odevincenti/E4-TPF-G2/Mediciones/scope2_tpf1.png

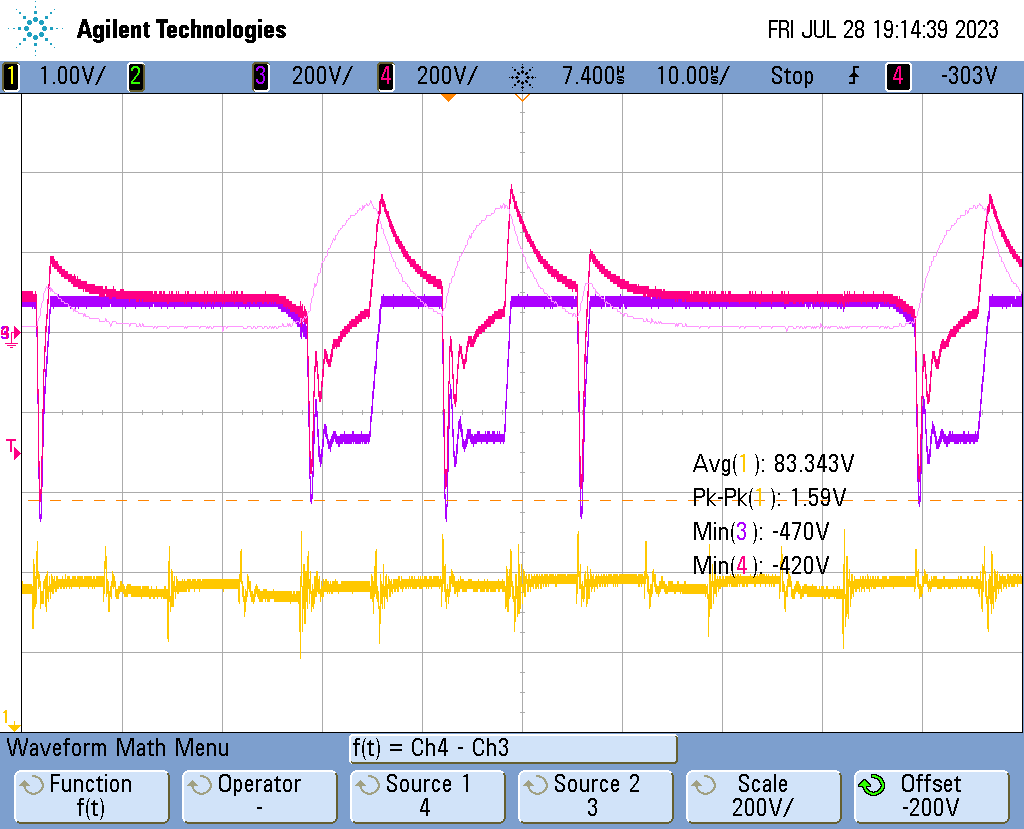
Mediciones/scope2_tpf1.png
