odevincenti/E4-TPF-G2/Mediciones/scope_tpf0.png

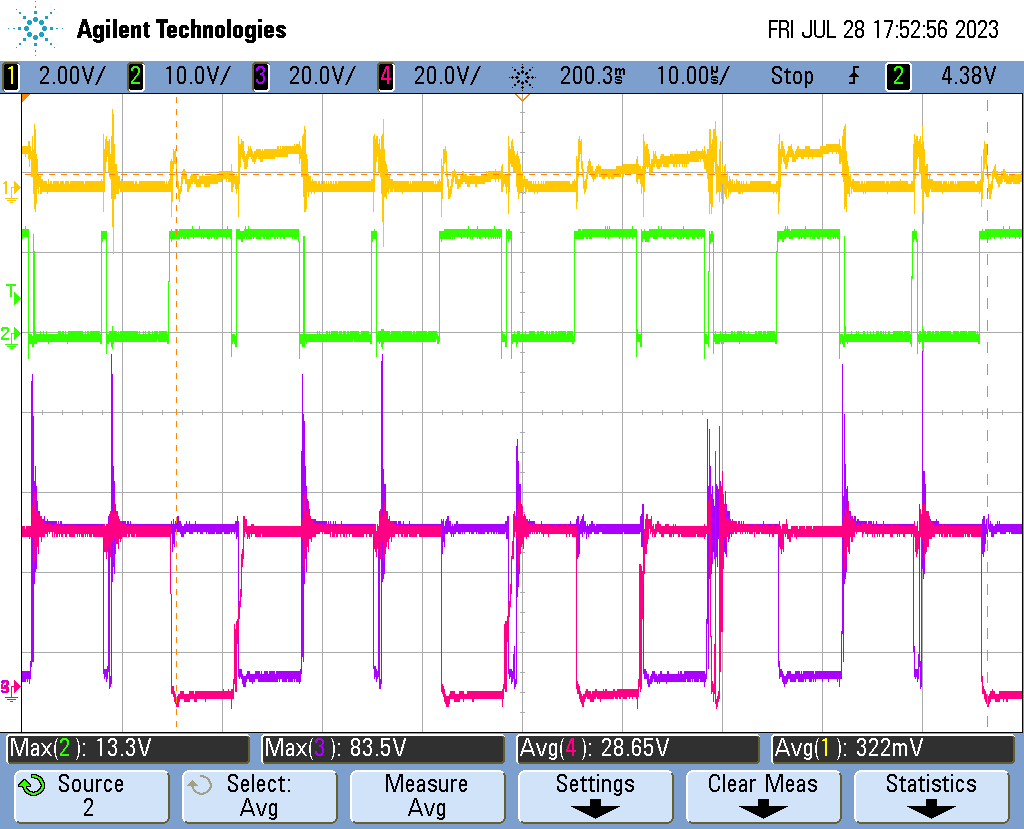
Mediciones/scope_tpf0.png
