odevincenti/E4-TPF-G2/Mediciones/scope_tpf1.png

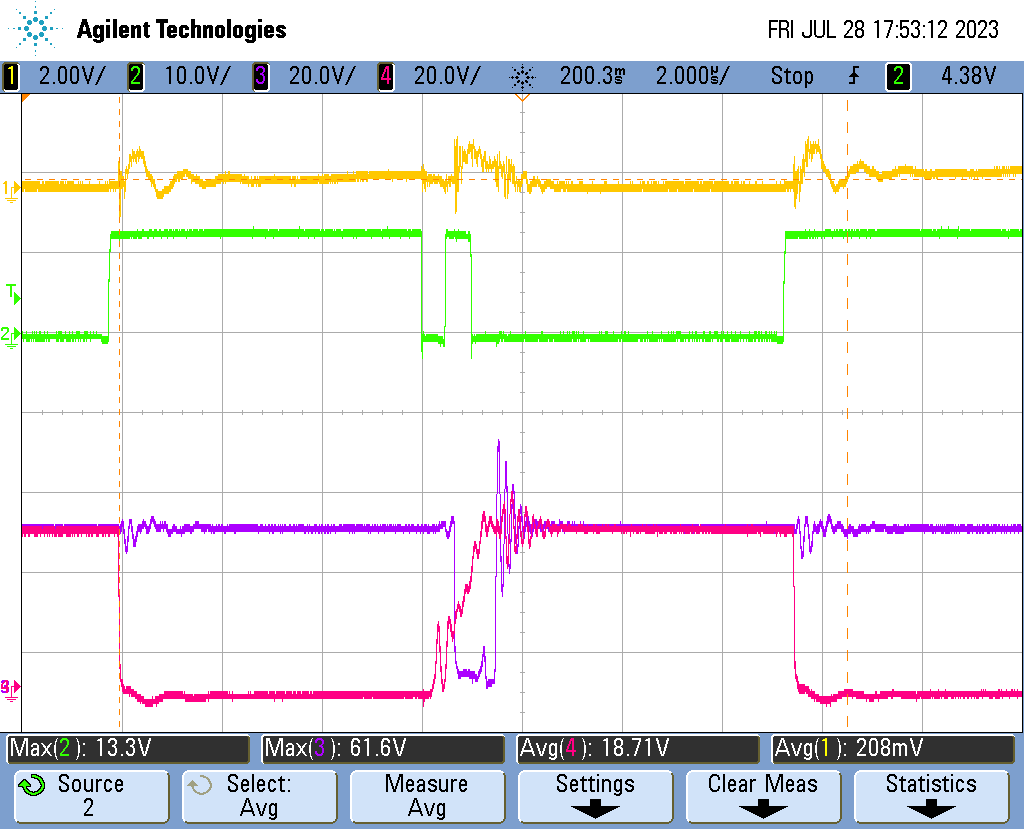
Mediciones/scope_tpf1.png
