odevincenti/E4-TPF-G2/Mediciones/scope_tpf2.png

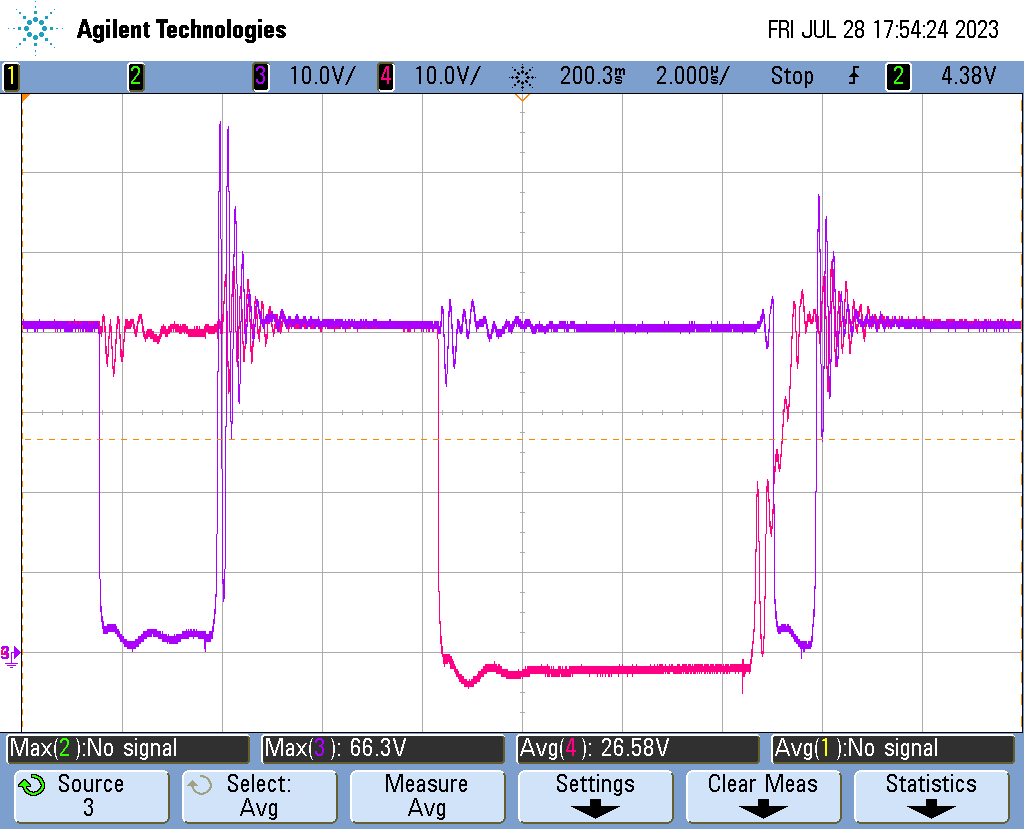
Mediciones/scope_tpf2.png
