odevincenti/E4-TPF-G2/Mediciones/scope_tpf3.png

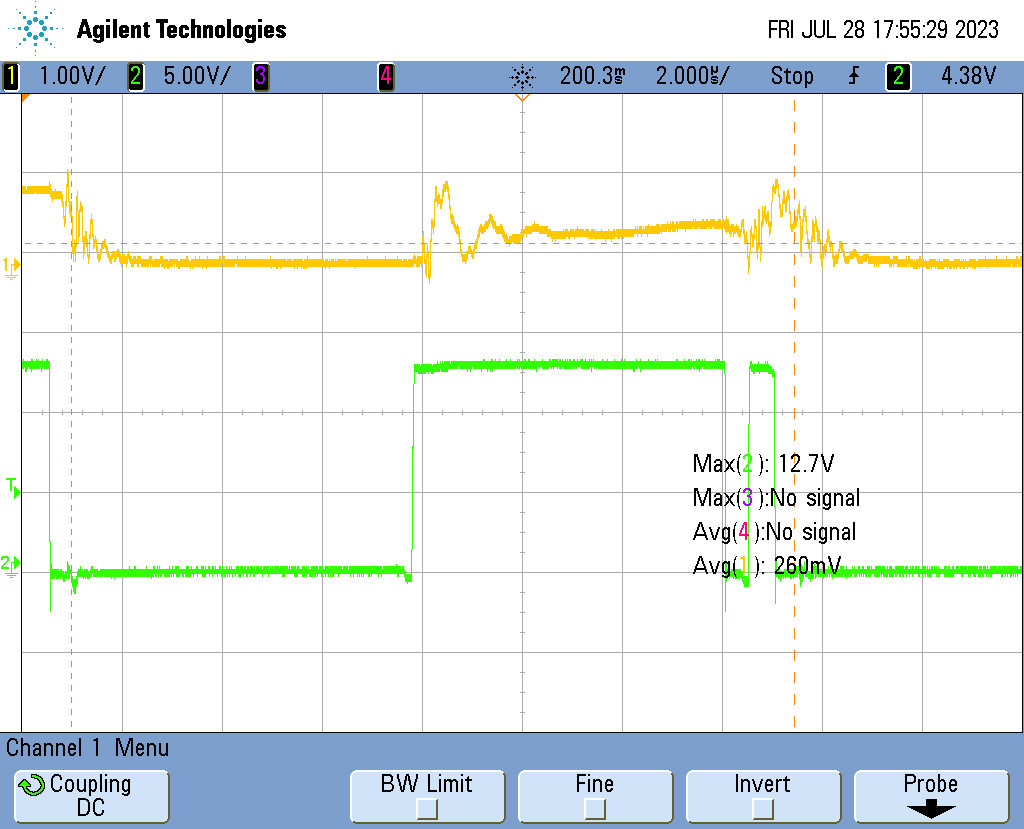
Mediciones/scope_tpf3.png
