odevincenti/E4-TPF-G2/Mediciones/scope_tpf4.png

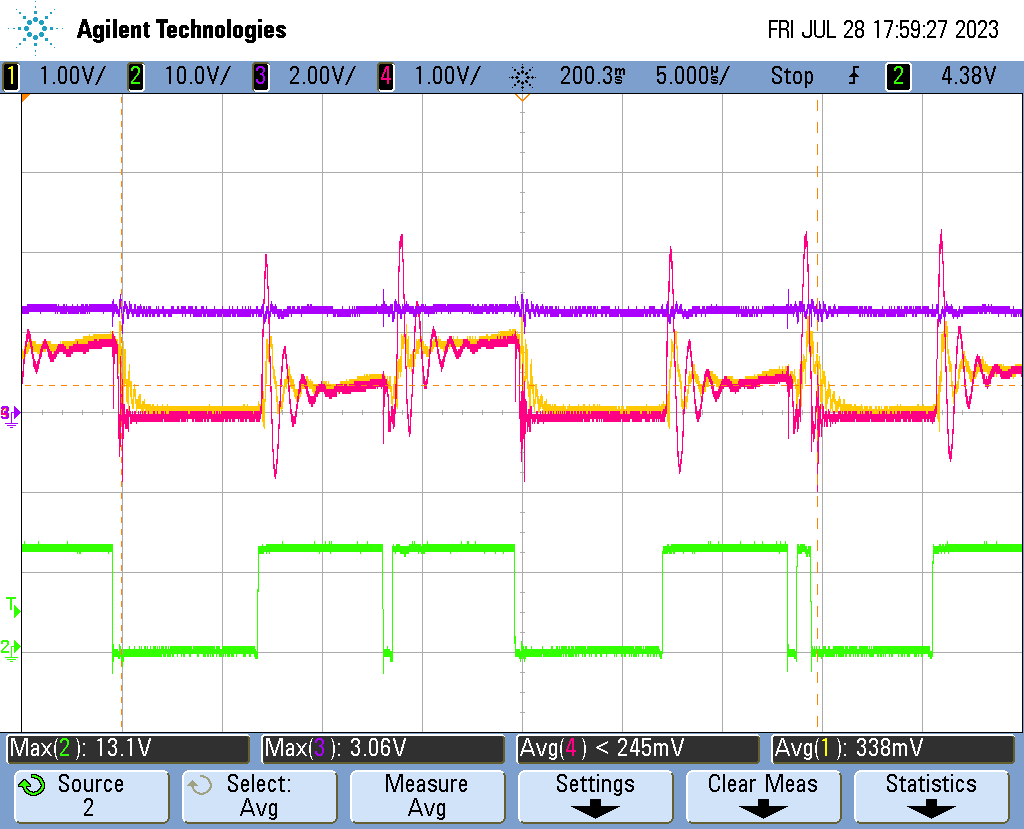
Mediciones/scope_tpf4.png
