odevincenti/E4-TPF-G2/Mediciones/scope_tpf5.png

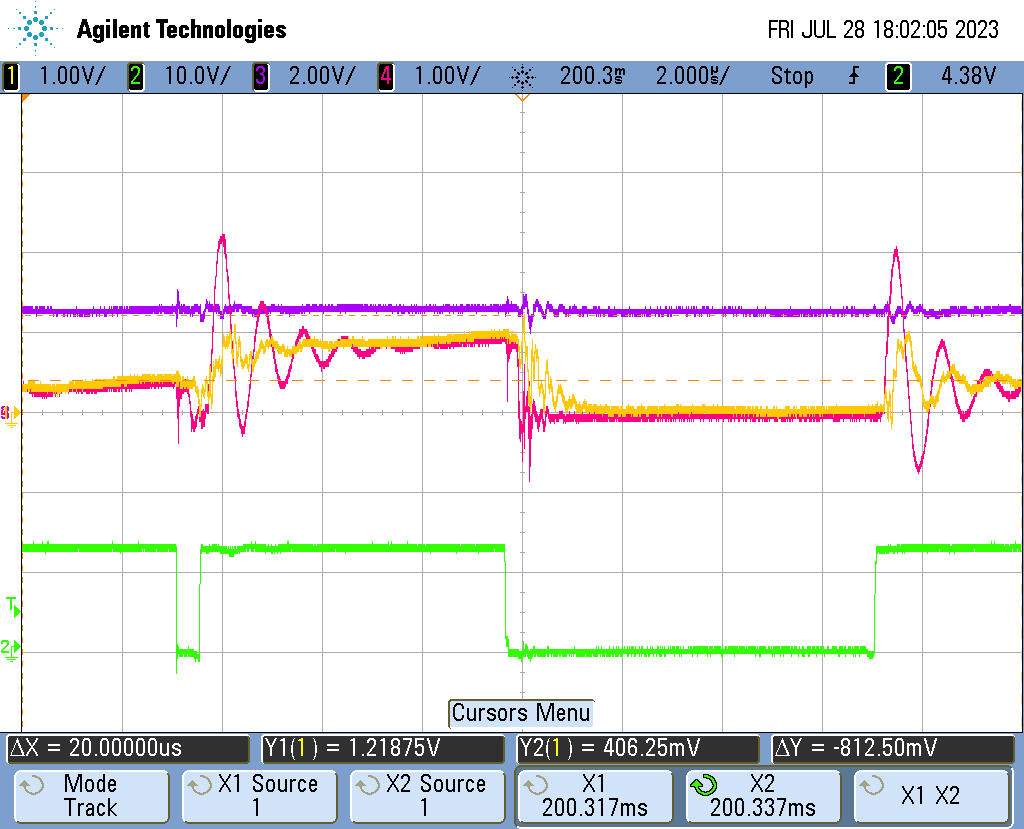
Mediciones/scope_tpf5.png
