odevincenti/E4-TPF-G2/Mediciones/scope_tpf6.png

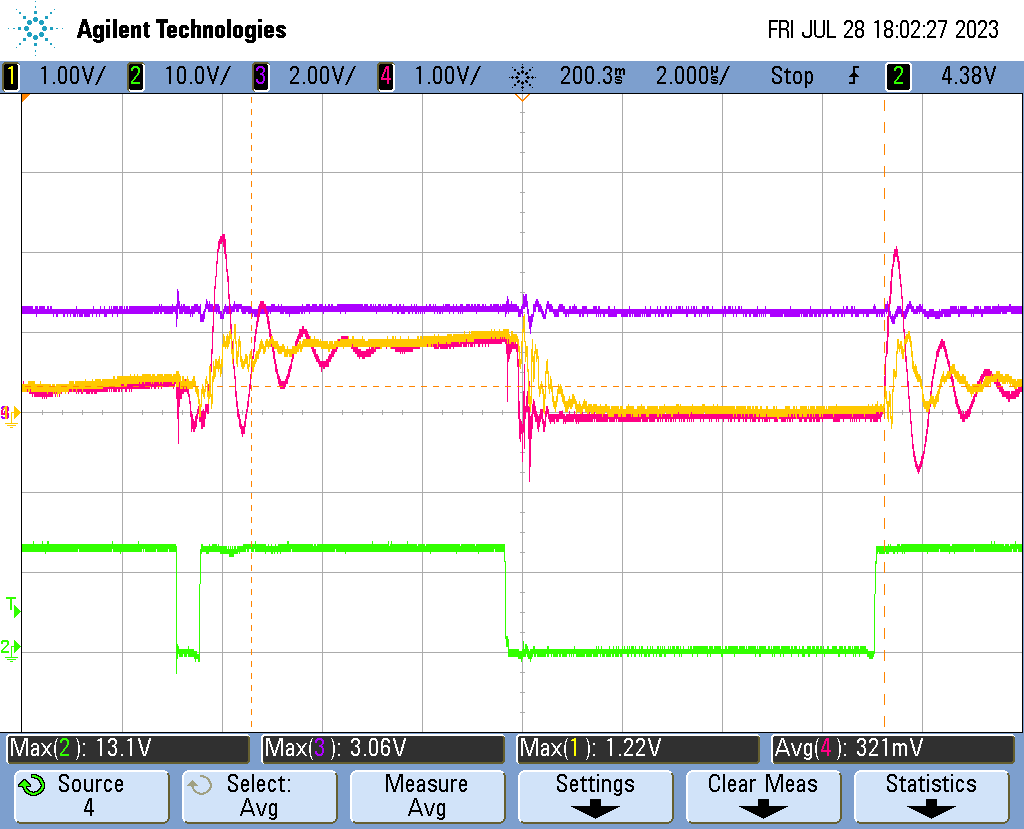
Mediciones/scope_tpf6.png
