odevincenti/E4-TPF-G2/Scripts/Flyback_Interleave.png

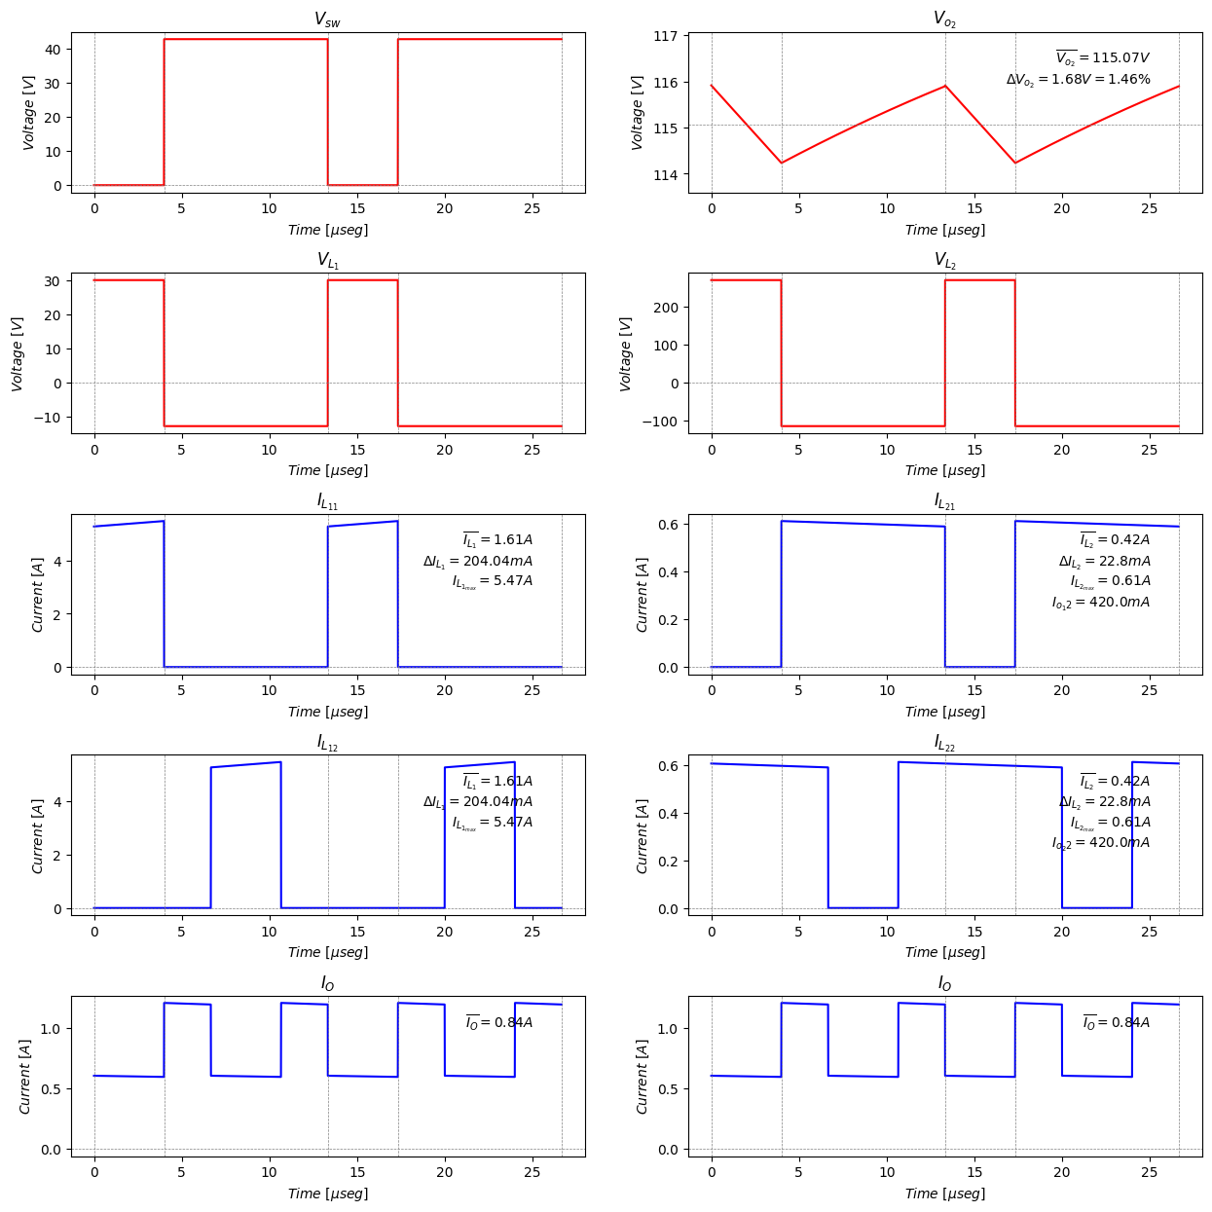
Scripts/Flyback_Interleave.png
