odevincenti/E4-TPF-G2/PCB/TPF-EIV-G2/Schematic.pdf

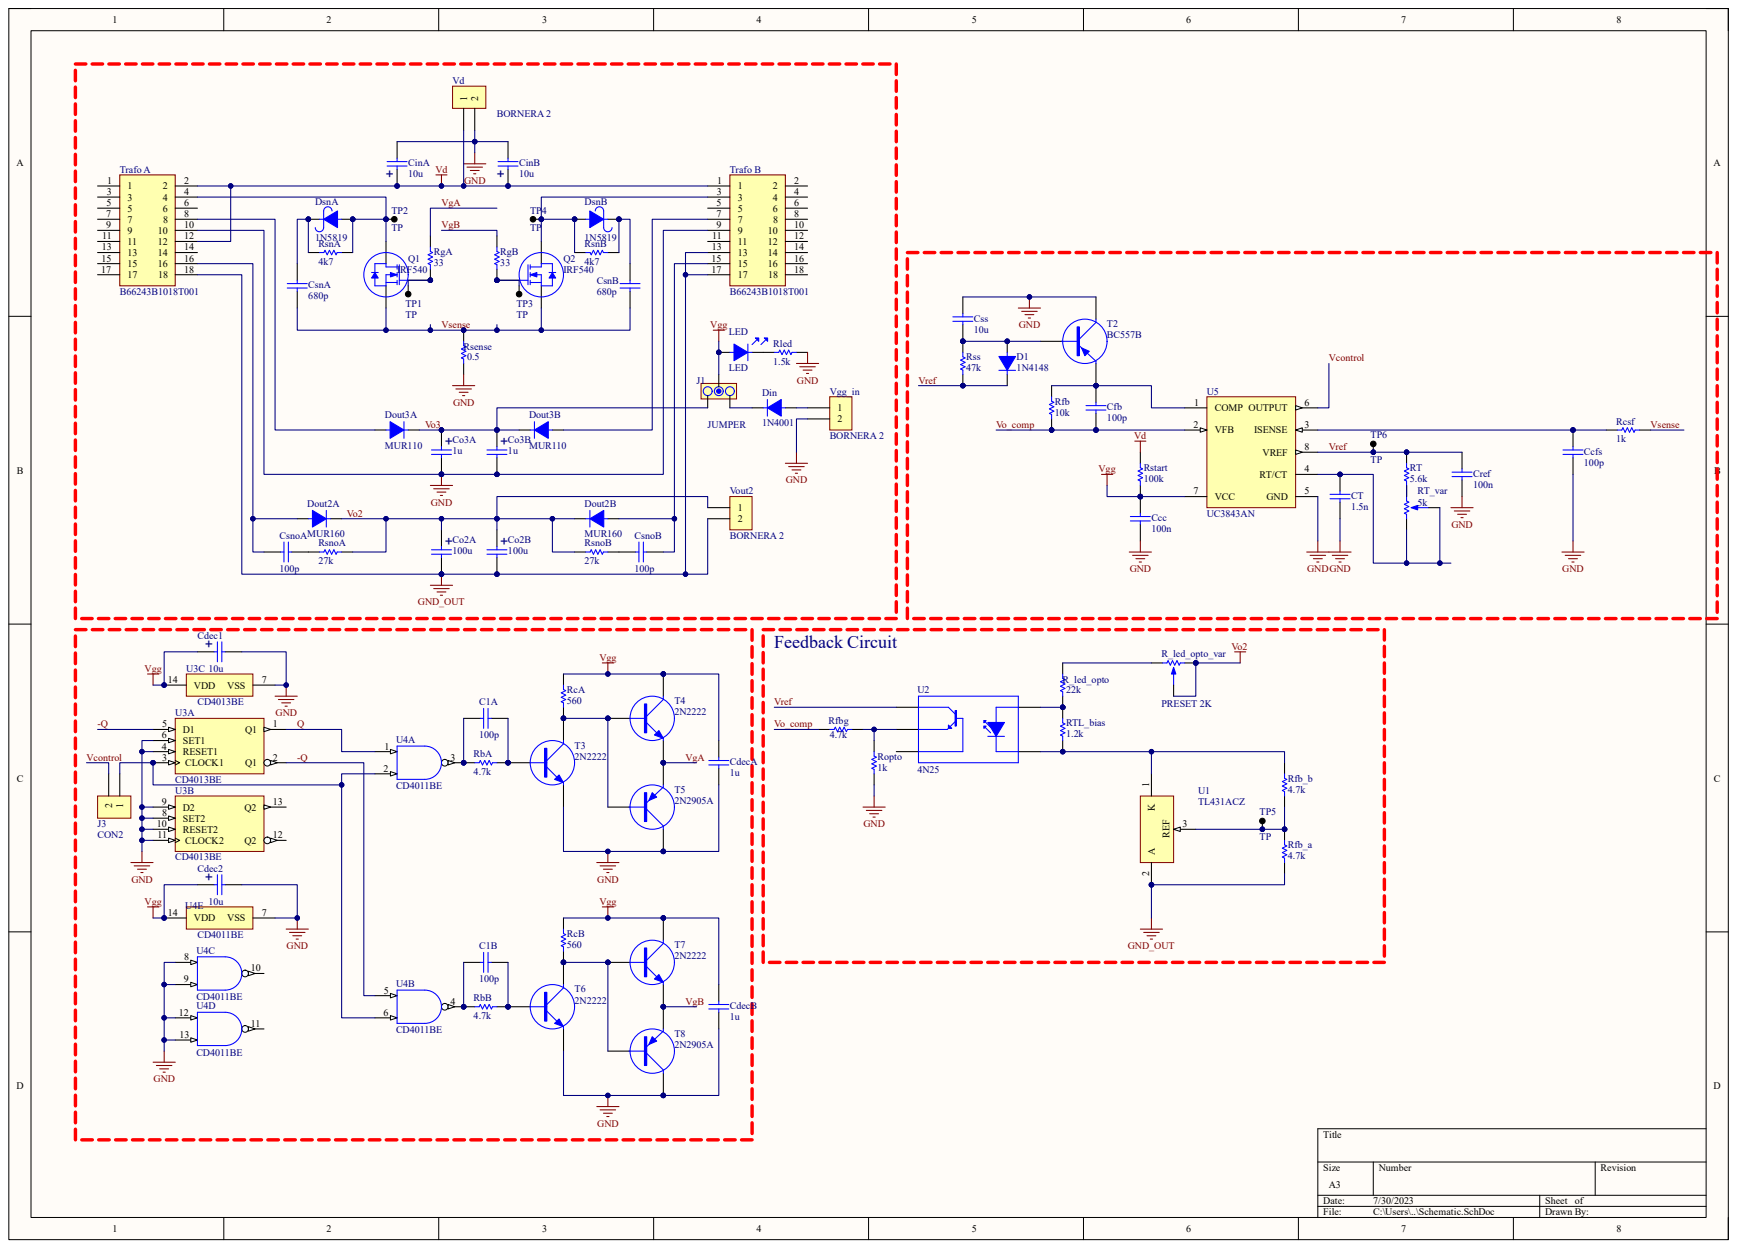
[picture p19: page 1]
