odevincenti/E4-TPF-G2/PCB/TPF-EIV-G2/E4_TPF.pdf

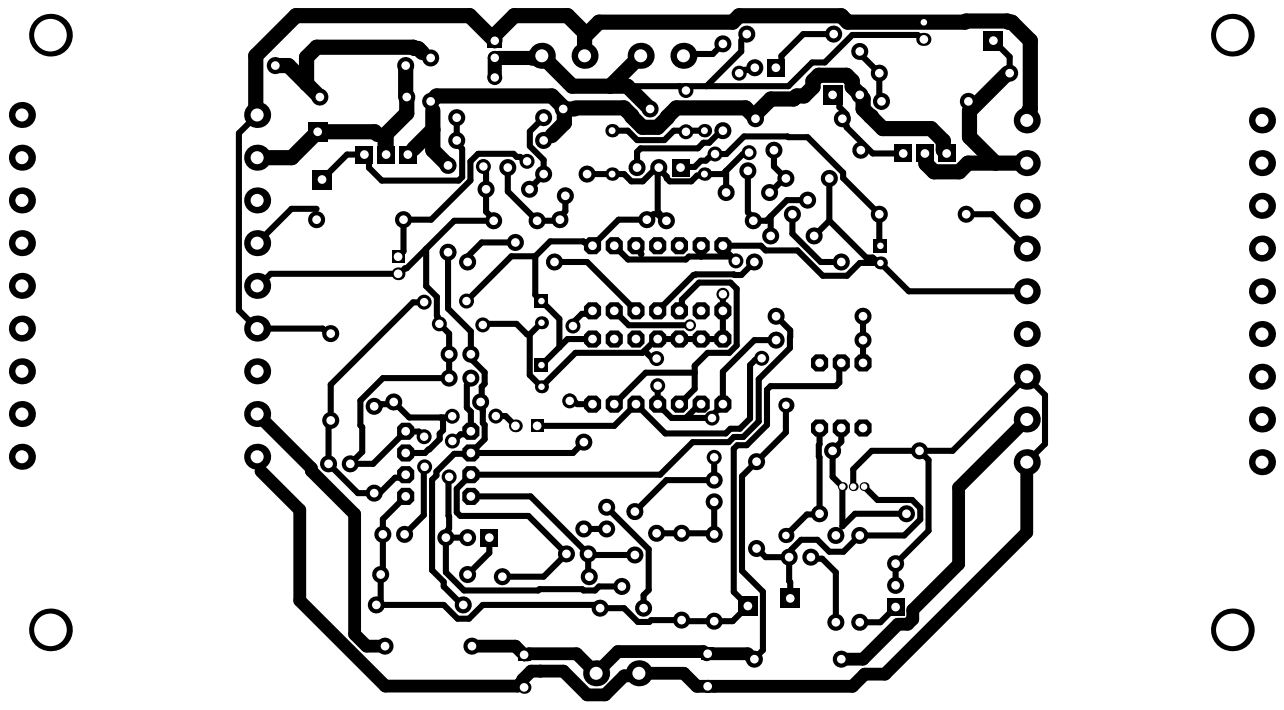
[picture p20: page 1]
