odevincenti/E4-TPF-G2/PCB/TPF-EIV-G2/E4_TPF_Top.pdf

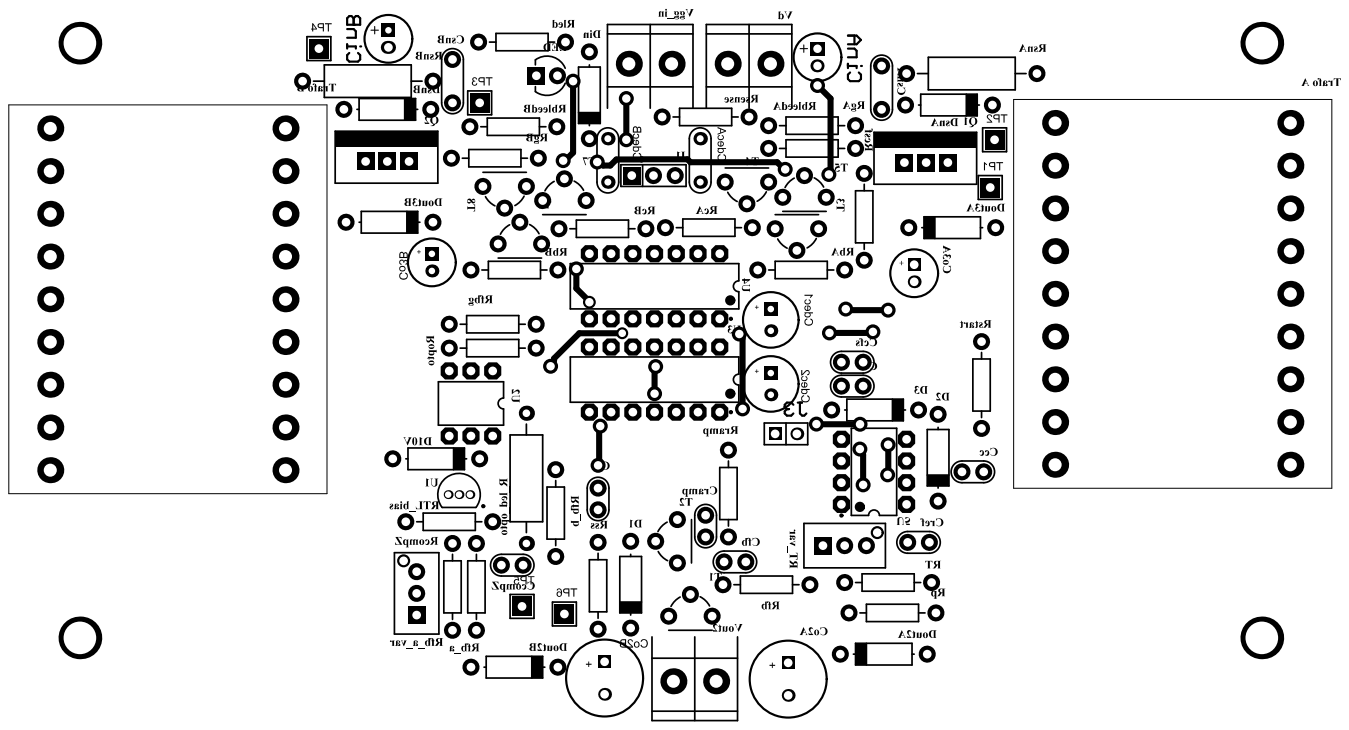
[picture p21: page 1]
