odevincenti/E4-TPF-G2/Simulaciones/Interleaved_Flyback_Experimental.asc

C2: cap; 1µ
C3: cap; 1µ
Ccc: cap; 100n
Ccfs: cap; 1n
Cfb: cap; 180n
Cramp: cap; 10n
Cref: cap; 100n
CsnA: cap; 680p
CsnB: cap; 680p
Css: cap; 10µ
CT: cap; 1.5n
D1: schottky; 1N5817
D2: schottky; 1N5817
D2A: diode; MUR160
D2B: diode; MUR160
D3A: diode; MUR110
D3B: diode; MUR110
D10V: zener; BZX84C10L
DsnA: schottky; 1N5819
DsnB: schottky; 1N5819
Dss: diode; 1N4148
ESR2: res; 0.2
ESR3: res; 0.2
L1A: ind2; 476µ
L1B: ind2; 476µ
L2A: ind2; 38.1m
L2B: ind2; 38.1m
L3A: ind2; 933µ
L3B: ind2; 933µ
LdA: ind; 29.4µ
LdB: ind; 29.4µ
LED: LED
Q1: npn; BC547B
Q1A: npn; 2N2222
Q1B: npn; 2N2222
Q2A: pnp; 2N2905A
Q2B: pnp; 2N2905A
Q3: pnp; BC557B
QcA: npn; 2N2222
QcB: npn; 2N2222
RbA: res; 4.7k
RbB: res; 4.7k
RbleederA: res; 10k
RbleederB: res; 10k
RcA: res; 560
RcB: res; 560
Rcsf: res; 470
Rfb: res; 10k
Rfb_a: res; 4.7k
Rfb_b: res; 4.7k
Rfbg: res; 10k
RgA: res; 33
RgB: res; 33
rL1A: res; 0.1
rL1B: res; 0.1
RL2: res; 1.1k
rL2A: res; 2
rL2B: res; 2
RL3: res; 220
rL3A: res; 0.1
rL3B: res; 0.1
Rled: res; 1k
Rled_bias: res; 1.2k
Rled_opto2: res; 1
Rled_opto: res; 24.2k
Ropto: res; 1k
Rp: res; 82k
Rramp: res; {Rramp}
Rsense: res; 0.47
RsnA: res; 220
RsnB: res; 220
Rss: res; 47k
Rstart: res; 100k
RT: res; 5.6k
RT_var: res; 1.15k
U1: TL431
U2: CD4013B; VDD={VDD}  SPEED=1.0  TRIPDT=5e-9
U3: CD4011B; VDD={VDD}  SPEED=1.0  TRIPDT=5e-9
U4: CD4011B; VDD={VDD}  SPEED=1.0  TRIPDT=5e-9
UA: irf540
UB: irf540
V1: voltage; 25
V2: voltage; PULSE(0 18 0 0 0 10 10)
V3: voltage; {VDD}
V4: voltage; PULSE(110 115 0 3.33u 3.33u 0 6.66u)
V5: voltage; SINE(0 0.6 2Meg 0 1Meg) trigger V(osc)>1.044
VA1: voltage; PULSE(0 18 0 0 0 3.3u 6.665u)
X1: UC3843A
X2: 4n35h
Named nets: 0, Vd, VgA, VgB, Vgg, Vcontrol, Vo3, Vsense, Vo2, Err, Vfb, Vref, Vcc, Out, Ifb, Osc, Vo_comp, Q, _Q, VDD, Vfeed, TLREF, TLK
Directivas Spice
.tran 0 10m 10n uic
KA L1A L2A L3A 1
KB L1B L2B L3B 1
Preset 5k
Preset
100 Ohm
Fuente para simular
En el esquematico real Vo3 es Vgg
Interleaved Flyback
Circuito de disparo
Circuito de control
Realimentación
Electrónica IV - TP Final 2023 - Grupo 2
.param VDD=18V
.lib CD4000.lib
.step param Rramp list 10k 100k 1Mega
.param Rramp 780k
.model MUR160 D(Is=1.043p Rs=5 Ikf=2.705m N=1 Xti=2 Eg=1.11 Cjo=28.43p M=.6225 Vj=.75 Fc=.5 Isr=7.011n Nr=2 Tt=123.3n Iave=1.0A Vpk=600.0V mfg=Motorola type=silicon Vp=25m)
