odevincenti/E4-TPF-G2/Simulaciones/Testing_TL431.asc

CcompZ: cap; 0.01µ
R1: res; {R}
R2: res; 200
RcompZ: res; 88.7k
Rfb_a: res; 2.49k
Rfb_b: res; 9.53k
Rfbg: res; 4.99k
Rled_opto: res; 5k
Ropto: res; 1k
U1: tl431
V4: voltage; {12+I*R}
V6: voltage; 5
X2: 4n35h
Named nets: Vo2, 0, Vo_comp, Vref
Directivas Spice
.tran 0 100m 0 1u uic
Realimentación
.param R = 10
.param I = 50mA
