odevincenti/E4-TPF-G2/Simulaciones/Testing_TL431_b.asc

R1: res
R2: res; 1.3k
Rfb_a: res; 5k
Rfb_b: res; 5k
U1: tl431
V4: voltage; 112.5
Named nets: Vo2, 0
Directivas Spice
.tran 0 100m 0 1u uic
Realimentación
.param R = 100
.param I = 30mA
