odevincenti/E4-TPF-G2/Simulaciones/TL431_test.asc

R1: res; 1000
R2: res; 15K
R3: res; 5K
U1: TL431
V1: voltage; 20
Named nets: 0, Vout
.tran .01
