odevincenti/E4-TPF-G2/Simulaciones/Prueba_Disparo.asc

Q1A: npn; 2N2222
Q1B: npn; 2N2222
Q2A: pnp; 2N2905A
Q2B: pnp; 2N2905A
QcA: npn; BC547C
QcB: npn; BC547C
R1: res; 10k
R2: res; 10k
RbA: res; 1k
RbB: res; 1k
RcA: res; 560
RcB: res; 560
U1: CD4013B; VDD={VDD}  SPEED=1.0  TRIPDT=5e-9
U2: CD4011B; VDD={VDD}  SPEED=1.0  TRIPDT=5e-9
U3: CD4011B; VDD={VDD}  SPEED=1.0  TRIPDT=5e-9
V1: voltage; 18
V2: voltage; PULSE(0 {VDD} 0 0 0 10 10)
VA1: voltage; PULSE(0 {VDD} 0 0 0 3.3u 6.665u)
Named nets: 0, VgA, VgB, Vgg, Vcontrol, Q, _Q, Vo3, VDD
Directivas Spice
.tran 0 10m 0 1u uic
Fuente para simular
En el esquematico real Vo3 es Vgg
Circuito de disparo
Electrónica IV - TP Final 2023 - Grupo 2
.lib CD4000.lib
.param VDD=18V
