odevincenti/E4-TPF-G2/Simulaciones/PWM_test.asc

Ccfs: cap; 100p
Cfb: cap; 1n
Cgg: cap; 100n
Cref: cap; 100n
CT: cap; 1.5n
R1: res; 100k
Rcsf: res; 1k
Rfb: res; 330k
RT: res; 7.65k
V1: voltage; 18
V2: voltage; SINE(2.4885 1 1k)
V3: voltage; PULSE(0 0.014 0 2u 0.001u 0.001u 6.665u)
V4: voltage; PULSE(0 0.548 0 4.4n 20n 2u 6.665u)
V5: voltage; PULSE(0 0.023 0 2u 4.664u 0.001u 6.665u)
X1: UC3843A
Named nets: 0, Vgg, Vo_comp, Vsense, Err, Vfb, Ref, Vcc, Out, Ifb, Osc, 1, Vcontrol
.tran 0 3m 0 uic
