odevincenti/E4-TPF-G2/Simulaciones/UC3843A-test.asc

C1: cap; 1n
C2: cap; 100n
C3: cap; 100µ
C4: cap; 2.2n
C5: cap; 100p
C6: cap; 10µ
D1: schottky; 1N5819
L1: ind; 5m; Rser=.1 Rpar=100k
R1: res; 100k
R2: res; 100k
R3: res; 330k
R4: res; 10k
R5: res; 100k
R6: res; 3.9k
R7: res; 10
R8: res; 2
V1: voltage; 25; Rser=1
V2: voltage; 0V
X1: UC3843A
Named nets: COM, Err, Vfb, Ref, Vcc, Out, Ifb, Osc, 5V, 1, Is, 0
.tran 0 3m 1u .5u uic
Ground Isolation Test Voltage
(set to 100V to test isolation)
UC3844A Behavioral Model Test Circuit
copyright 2003 by analog@ieee.org
