odevincenti/E4-TPF-G2/Simulaciones/UC3844A-test.asc

C1: 1n
C2: 100n
C3: 100µ
C4: 2.2n
C5: 100p
C6: 10µ
D1: 1N5819
L1: 5m; Rser=.1 Rpar=100k
R1: 100k
R2: 100k
R3: 330k
R4: 10k
R5: 100k
R6: 3.9k
R7: 100
R8: 5
V1: 25; Rser=1
V2: 0V
X1: UC3844A
Named nets: COM, Err, Vfb, Ref, Vcc, Out, Ifb, Osc, 5V, 1, Is, 0
.tran 0 3m 1u .5u uic
Ground Isolation Test Voltage
(set to 100V to test isolation)
UC3844A Behavioral Model Test Circuit
copyright 2003 by analog@ieee.org
