odevincenti/E4-TPF-G2/Simulaciones/Interleaved_Flyback_ClosedLoop.asc

C2: cap; 1µ
C3: cap; 1µ
Ccfs: cap; 100p
CcompZ1: cap; 10n
Cfb: cap; 17n
Cgg: cap; 100n
Cramp: cap; 1n
Cref: cap; 100n
CT: cap; 1.5n
D1: zener; UDZV10B
D2A: diode; MUR460
D2B: diode; MUR460
D3A: diode; MUR110
D3B: diode; MUR110
ESR2: res; 0.2
ESR3: res; 0.2
L1A: ind2; 476µ
L1B: ind2; 476µ
L2A: ind2; 38.1m
L2B: ind2; 38.1m
L3A: ind2; 933µ
L3B: ind2; 933µ
LED: LED
Q1: npn
Q1A: npn; 2N2222
Q1B: npn; 2N2222
Q2A: pnp; 2N2905A
Q2B: pnp; 2N2905A
QcA: npn; BC547C
QcB: npn; BC547C
R1: res; 680k
RbA: res; 1k
RbB: res; 1k
RcA: res; 560
RcB: res; 560
Rcsf: res; 1k
Rfb: res; 10k
Rfb_a1: res; 2.5k
Rfb_a_var1: res; 5
Rfb_b1: res; 110k
Rfbg1: res; 2.2k
RgA: res; 33
RgB: res; 33
rL1A: res; 0.1
rL1B: res; 0.1
RL2: res; 137
rL2A: res; 2
rL2B: res; 2
RL3: res; 220
rL3A: res; 0.1
rL3B: res; 0.1
Rled: res; 1k
Rled_opto1: res; 47k
Ropto1: res; 1k
Ropto2: res; 2k
Rp: res; 12k
Rramp: res; 100k
Rsense: res; 0.1
RT: res; 6.85k
RTLbias1: res; 50k
U1: CD4013B; VDD={VDD}  SPEED=1.0  TRIPDT=5e-9
U2: CD4011B; VDD={VDD}  SPEED=1.0  TRIPDT=5e-9
U3: CD4011B; VDD={VDD}  SPEED=1.0  TRIPDT=5e-9
U4: tl431
UA: irf540
UB: irf540
V1: voltage; 30
V2: voltage; PULSE(0 18 0 0 0 10 10)
V3: voltage; 18
V4: voltage; PULSE(110 115 0 3.33u 3.33u 0 6.66u)
VA1: voltage; PULSE(0 18 0 0 0 3.7u 6.665u)
X1: UC3843A
X2: 4n35h
Named nets: 0, Vd, VgA, VgB, Vgg, Vcontrol, Vo3, Vsense, Vo2, Err, Vfb, Vref, Vcc, Out, Ifb, Osc, Vo_comp, Q, _Q, VDD, Vfeed
Directivas Spice
.tran 0 100m 0 1u uic
KA L1A L2A L3A 1
KB L1B L2B L3B 1
.param VDD=18V
.lib CD4000.lib
Preset
100 Ohm
