odevincenti/E4-TPF-G2/Simulaciones/UC3843A.asc

A1: schmtbuf; Vt=8.2 Vh=0.3; Vhigh=2.5 Rout=1k
A2: diffschmitt; vt=1m vh=1m tripdt=3n trise=100n
A3: srflop; td=10n trise=200n
A4: or; Vhigh=6 Vlow=0.7 Isrc=1m Isink=-6m; Rclamp=1 g=5 Rout=25k Cout=5p; powerup=!V(fault,Com)
A5: or; trise=100n
A6: schmtinv; Vt=4.8 Vh=.1; trise=200n
A7: schmtbuf; vt=1.75 vh=0.85 td=10n trise=100n
C1: cap; 1p
C2: cap; 1p; Rpar=240
C3: cap; 10p
C4: cap; 5p; Rpar=10meg
C5: cap; 1p
C6: cap; 1p; Rpar=10G
C7: cap; 5p
C8: cap; 1p
C9: cap; 0.1p; Rpar=1e6
C10: cap; 20p
C11: cap; 20p
D1: zener; 34V
D2: diode; V65
D3: diode; 2R
D4: diode; 1R
G2: g2; 8.3m
I1: current; TBL(0 0 1 .2m)
R1: res; 8e6
R2: res; 240
R3: res; 280m
R4: res; 165k
R5: res; 75k
S1: sw; ref
S2: sw; Ho
S3: sw; Lo
Named nets: Out, COM, Ref, Osc, Vfb, Err, Ifb, 2v5, Vcc, Com, fault
.model 1R d(Vfwd=1 Ron=1)
.model 2R d(Vfwd=1.3 Ron=2e6)
.model 34V d(Ron=.5 Vfwd=.5 Vrev=34 Rrev=22)
.model ref sw(Vh=-11m Ilimit=100m)
.model Ho sw(Vt= .48 Vh=-.25 Ron=2 Roff=100k Vser=1.2)
.model Lo sw(Vt=-.52 Vh=-.25 Ron=6 Roff=300k)
.model V65 d(Vfwd=0.65)
>> UC3843A <<
LTspice A-Device Behavioral Model
Copyright 2004 by analog@ieee.org
Modified by Hendrik Jan Zwerver to standard A devices
NOTES:
UC3842A: for A1 Vt=13  Vh=3.0 and bypass A3 (delete)
UC3843A: for A1 Vt=8.2 Vh=0.3 and bypass A3 (delete)
UC3844A: for A1 Vt=13  Vh=3.0; for A3 cycles=2
UC3845A: for A1 Vt=8.2 Vh=0.3; for A3 cycles=2
