odevincenti/E4-TPF-G2/Simulaciones/Interleaved_Flyback_Disparo_OpenLoop.asc

A1: dflop
AA: and
AB: and
C2: cap; 1µ
C3: cap; 1µ
CsnA: cap; 680p
CsnB: cap; 680p
D2A: diode; MUR460
D2B: diode; MUR460
D3A: diode; MUR110
D3B: diode; MUR110
DsnA: schottky; 1N5819
DsnB: schottky; 1N5819
ESR1: res; 0.2
ESR2: res; 0.2
L1A: ind2; 588.11µ
L1B: ind2; 588.11µ
L2A: ind2; 47.05031m
L2B: ind2; 47.05031m
L3A: ind2; 1152.69µ
L3B: ind2; 1152.69µ
LdA: ind; 29.4µ
LdB: ind; 29.4µ
LED1: LED
Q1A: npn; 2N2222
Q1B: npn; 2N2222
Q2A: pnp; 2N2905A
Q2B: pnp; 2N2905A
QcA: npn; BC547C
QcB: npn; BC547C
RbA: res; 1k
RbB: res; 1k
RcA: res; 560
RcB: res; 560
RgA: res; 33
RgB: res; 33
rL1A: res; 0.2
rL1B: res; 0.2
RL2: res; 137
rL2A: res; 0.7
rL2B: res; 0.7
RL3: res; 220
rL3A: res; 0.2
rL3B: res; 0.2
Rled1: res; 1k
Rsense: res; 0.1
RsnA: res; 220
RsnB: res; 220
UA: irf540
UB: irf540
V1: voltage; 30
V2: voltage; 18
VA1: voltage; PULSE(0 1 0 0 0 3.45u 6.665u)
Named nets: 0, Vd, VgA, VgB, Vgg, Vcontrol, Q, _Q, Vout2
Directivas Spice
.tran 0 20m 0 1u
KA L1A L2A L3A 1
KB L1B L2B L3B 1
