odevincenti/E4-TPF-G2/Simulaciones/Interleaved_Flyback_Completa.asc

A1: dflop
AA: and
AB: and
C2: cap; 1µ
C3: cap; 1µ
Ccc: cap; 100n
Ccsf: cap; 100p
Cfb2: cap; 100p
Cfb: cap; 10n
Cramp: cap; 10n
Cref: cap; 100n
CsnA: cap; 680p
CsnB: cap; 680p
Css: cap; 10µ
CT: cap; 1.5n
D2A: diode; MUR460
D2B: diode; MUR460
D3A: diode; MUR110
D3B: diode; MUR110
DsnA: schottky; 1N5819
DsnB: schottky; 1N5819
Dss: diode; 1N4148
ESR1: res; 0.2
ESR2: res; 0.2
L1A: ind2; 588.11µ
L1B: ind2; 588.11µ
L2A: ind2; 47.05031m
L2B: ind2; 47.05031m
L3A: ind2; 1152.69µ
L3B: ind2; 1152.69µ
LdA: ind; 29.4µ
LdB: ind; 29.4µ
LED1: LED
Q1: npn
Q1A: npn; 2N2222
Q1B: npn; 2N2222
Q2: pnp; BC557B
Q2A: pnp; 2N2905A
Q2B: pnp; 2N2905A
QcA: npn; BC547C
QcB: npn; BC547C
R210: res; 33k
RbA: res; 1k
RbB: res; 1k
RcA: res; 560
RcB: res; 560
Rcsf: res; 1k
Rfb2_a: res; 1.8k
Rfb2_a_var: res; 60
Rfb2_b: res; 82k
Rfb: res; 10k
Rfbg: res; 4.7k
RgA: res; 33
RgB: res; 33
rL1A: res; 0.1
rL1B: res; 0.1
RL2: res; 137
rL2A: res; 0.2
rL2B: res; 0.2
RL3: res; 220
rL3A: res; 0.1
rL3B: res; 0.1
Rled1: res; 1k
Rled: res; 15k
Ropto: res; 1k
Rramp: res; 330k
Rsense: res; 0.1
RsnA: res; 220
RsnB: res; 220
Rss: res; 47k
Rstart: res; 100k
RT: res; 5.6k
U1: tl431
U2: UCC28C45_STEADY
UA: irf540
UB: irf540
V1: voltage; 30
V2: voltage; 18
VA1: voltage; PULSE(0 1 0 0 0 3.3u 6.665u)
X2: 4n35h
Named nets: 0, Vd, VgA, VgB, Vgg, Vcontrol, Q, _Q, Vo3, Vref, Vsense, Vo2, Vo_comp
Directivas Spice
.tran 0 20m 0 1u uic
KA L1A L2A L3A 1
KB L1B L2B L3B 1
