odevincenti/E4-TPF-G2/Simulaciones/4N35h.asc

B1: bi2; I=TABLE(I(V1), 0,0, 0.3m,0, 0.4m,0.002m, 0.5m,0.01m, 1m,0.08m, 1.5m,0.25m, 2m,0.6m, 2.5m,1.25m, 3m,1.9m, 4m,3.6m, 5m,6m, 7m,11m, 9m,16m, 10m,18.5m, 15m,30m, 20m,41m, 25m,49m, 30m,55m, 40m,60m, 50m,61m)
C1: cap; 20p
C2: cap; 1µ
C3: cap; 2p
C4: cap; 0.3p
C5: cap; 0.3p
C6: cap; 10p
C7: cap; 10p
D1: diode; LED
G1: g; 3.2m
Q1: npn; NPN1 1
R1: res; 10G
R2: res; 1
V1: voltage; 0
Named nets: A, K, E, C, 0, B
.model LED D(Is=1e-15 Rs=2 N=1.5 Eg=1.7 CJO=18p TT=100n)
Optocoupler 4N35  200%
I=IF(I(V1)>0, I(V1),0)
.model NPN1 NPN(Is=1e-12 BF=400 VAF=100 IKF=.1 ISE=1e-11 NE=2 CJC=19p CJE=9p TF=.5e-8 Rb=100 Rc=5 Re=1)
