odevincenti/E4-TPF-G2/Simulaciones/UC3844A.asc

B2v5: bv; V = 2.5*V(ok)
Bdrv: bi; I = V(ff2) & V(ok) & V(latch) & !V(hys); Rpar=1; tripdt=30n
Be1: bi; I = limit(10*V(er,Err),.8m,-6m)*V(ok)
Be2: bv; V = limit(3k*V(2v5,Vfb),6,.7)
Bff1: bi2; I = (V(ff1)& V(hys)) | ( V(ff2)&!V(hys)); tripdt=30n; Rpar=1
Bff2: bi2; I = (V(ff2)&!V(hys)) | (!V(ff1)& V(hys)); tripdt=30n; Rpar=1
Bi: bi; I = 11m*V(ok) + V(drv)*I(Vo); Rpar=47k
BIer: bi; I = limit(V(Err,Com)-1.2,3,0)-3*V(Ifb,Com); Rpar=1
Blch: bi; I = (u(V(Ierr)) & V(latch)) | V(hys); Rpar=1; tripdt=30n
Bo: bi; I = V(drv)*V(Vcc,Com)+table(-I(Vo),-1m,-1.3,0,0,.09,.5,.11,1.3,.3,1.4,1,5); Rpar=1; tripdt=30n
Bok: bi; I = u(V(Vcc,Com)-16+6*V(ok)); Rpar=1
Bosc: bi; I = 8.3m*u(V(hys)+V(Osc,Com)-2.6); tripdt=300n
Bref: bi; I = limit(5*V(ok)-V(5,Com),80m,0)
Cdrv: cap; 10n
Ce1: cap; 30p
Ce2: cap; 10n
Cff1: cap; 30n; IC=1
Cff2: cap; 30n
CIer: cap; 300n
Clch: cap; 10n
Co: cap; 30n
Cok: cap; 100n
Cosc: cap; 50p; Rpar={1.7/8.3m}
Cref: cap; 10n
Di: zener; 34V
Re1: res; 5e6
Re2: res; 50k
Rref: res; 2
Vo: voltage; 0
Named nets: er, latch, hys, 0, ok, Out, Vcc, Ierr, Ref, Osc, Com, Ifb, 5, Err, Vfb, drv, 2v5, COM, o, e, ff1, ff2
.model 34V D(Ron=.5 Vfwd=.5 Vrev=34 Rrev=22)
>> UC3844A <<
Behavioral Model
Copyright 2003 by
analog@ieee.org
ff1:
ff2:
