odevincenti/E4-TPF-G2/Simulaciones/Interleaved_Flyback_Ideal_OpenLoop.asc

C2: cap; 10µ
C3: cap; 10µ
D2A: diode
D2B: diode
D3A: diode
D3B: diode
ESR2: res; 0.2
ESR3: res; 0.2
L1A: ind2; 588.11µ
L1B: ind2; 588.11µ
L2A: ind2; 47.05031m
L2B: ind2; 47.05031m
L3A: ind2; 1152.69µ
L3B: ind2; 1152.69µ
LED3: LED
R2: res; 68
R3: res; 10
RgA: res; 33
RgB: res; 33
rL1: res; 0.1
rL1A: res; 0.1
rL1B: res; 0.1
rL2A: res; 0.2
rL2B: res; 0.2
rL3: res; 0.1
Rled3: res; 1k
U1: irf540
U2: irf540
V1: voltage; 30
VA: voltage; PULSE(0 18 0 0 0 4u 13.33u)
VB: voltage; PULSE(0 18 6.665u 0 0 4u 13.33u)
Named nets: Vout2, Vout3, 0, Vd, VgA, VgB
KA L1A L2A L3A 1
Directivas Spice
.inc opamp.sub
.param Fs = 75k
.param Ts = 1/Fs
.param Ton = Ts* D
.param D=0.3
.tran 0 20m 0 1u
KB L1B L2B L3B 1
