odevincenti/E4-TPF-G2/Simulaciones/Interleaved_Flyback.asc

C2: cap
C3: cap
Cd: cap; 100n
Cf1: cap; 470n
Cf2: cap; 1n
Csn: cap
Css: cap; 5µ
CT: cap; 3.3n
D1: diode
D2A: diode
D2B: diode
D3A: diode
D3B: diode
ESR2: res; 0.2
ESR3: res; 0.2
L1A: ind2
L1B: ind2
L2A: ind2
L2B: ind2
L3A: ind2
L3B: ind2
LdA: ind
LdB: ind
LED3: LED
MA: nmos
MB: nmos
R1: res
R2: res
R3: res
R3bref: res; 10k
R3brefpot: res; 2.7k
Rao: res; 5.6k
Raref: res; 10k
Rbo: res; 33k
Rf1: res; 15k
Rf2: res; 22k
RgA: res
RgB: res
rL1: res; 0.1
rL1A: res
rL1B: res
rL2A: res
rL2B: res
rL3: res; 0.1
Rled3: res
Rsn: res
RT: res; 2.7k
V1: voltage; 280
V2: voltage; 16
Vgg: voltage; 16
Named nets: Vout2, Vout3, 0, Vds, Vosc, Vo_comp, Vref_comp, Vref, Vcontrol, Comp_out, Vinv, Vd, VgA, VgB
K1 L1A L2A L3A 1
Directivas Spice
.inc opamp.sub
fsw= 2/(CT*(RT*0.7))
Con CT=3.3nF y RT = 2.8kOhm
=> fsw = 75KHz
.inc SG3525A.sub
Frecuencia
Divisor Vo
Divisor Vref
Ponemos una fuente constante solo para simular,porque el modelo spice no contempla la carga inicial de un capacitor entre los 300V y esta parte
.param Fs = 75k
.param Ts = 1/Fs
.param Ton = Ts* D
.param D=0.3
.tran 0 100m 0 1u
Compensacion de Polos y Ceros
K1 L1B L2B L3B 1
