odevincenti/E4-TPF-G2/(list of files, drawings)

Other design files:
PCB/TPF-EIV-G2/B66243S1012T001.PcbLib
PCB/TPF-EIV-G2/B66243S1012T001.SchLib
PCB/TPF-EIV-G2/E4_TPF.PcbDoc
PCB/TPF-EIV-G2/Schematic.SchDoc
PCB/TPF-EIV-G2/TPF-EIV-G2.PrjPcb
