odevincenti/E4-TPF-G2/(commit log)

2023-06-30 Added Output current sum
2023-06-30 Arranca el closed loop
2023-07-04 Simulación para hacer andar el PWM
2023-07-05 Subo paper que puede servir
2023-07-09 Agrego ramp compensation + current sense filter
2023-07-10 Cálculos compensación de rampa
2023-07-14 Nuevos valoes de inductancia
2023-07-20 Finished PCB (?
    [B66243S1012T001.PcbLib, B66243S1012T001.SchLib, E4_TPF.PcbDoc, Schematic.SchDoc, TPF-EIV-G2.PrjPcb]
2023-07-20 Estabiliza closed loop a ~93V
2023-07-21 Estabiliza en 128V
2023-07-21 Pusheo para que no se rompa todo despues
2023-07-21 Simu final regula correctamente entre 110V y 115V
2023-07-23 Updated PCB
    [E4_TPF.PcbDoc, Schematic.SchDoc]
2023-07-26 Flyback experimental con simulación de snubber
2023-07-27 Updated Altium Schematic
    [Schematic.SchDoc]
2023-07-31 Updated Schem Altium
    [Schematic.SchDoc]
2023-07-31 Finished Schematic
    [Schematic.SchDoc]
2023-07-31 Fixed Typo
    [Schematic.SchDoc]
